zhengbingquant/zhengbingquant_Nano_V1/3. Docs/BOM_Board1_1_PCB2_2025-08-31.xlsx

No. | Quantity | Comment | Designator | Footprint | Value | Manufacturer Part | Manufacturer | Supplier Part | Supplier | LCSC Stock | JLCPCB Price | 淘宝链接 | JLCPCB Stock | LCSC Price
1 | 3 | XL-2012SURC | 3.3V,5V,D13 | LED0805-RD_RED |  | XL-2012SURC | XINGLIGHT(成兴光) | C965812 | LCSC
2 | 6 | 100nF | C2,C3,C9,C12,C14,C17 | C0805 | 100nF | CL21B104KBCWPNC | SAMSUNG(三星) | C346219 | LCSC
3 | 3 | 1uF | C7,C8,C13 | C0805 | 1uF | UMK212BJ105KG-T | TAIYO YUDEN(太诱) | C319195 | LCSC
4 | 1 | 330nF | C11 | C0805 | 330nF | CL21B334KBFNNNE | SAMSUNG(三星) | C73142 | LCSC
5 | 2 | 33pF | C18,C19 | C0805 | 33pF | 0805CG330J500NT | FH(风华) | C157687 | LCSC
6 | 1 | LMSD103AT1G | D1 | SOD-123_L2.8-W1.8-LS3.7-RD |  | LMSD103AT1G | LRC(乐山无线电) | C78727 | LCSC
7 | 1 | BSS138LT1G | Q1 | SOT-23-3_L2.9-W1.6-P1.90-LS2.8-BR |  | BSS138LT1G | onsemi(安森美) | C82045 | LCSC
8 | 2 | 22Ω | R1,R2 | R0603 | 22Ω | 0603WAF220JT5E | UNI-ROYAL(厚声) | C23345 | LCSC
9 | 2 | 5.1kΩ | R3,R4 | R0603 | 5.1kΩ | FRC0603F5101TS | FOJAN(富捷) | C2907044 | LCSC
10 | 1 | 100kΩ | R6 | R0805 | 100kΩ | 0805W8F1003T5E | UNI-ROYAL(厚声) | C149504 | LCSC
11 | 1 | 75Ω | R8 | R0805 | 75Ω | FRC0805J750 TS | FOJAN(富捷) | C2974040 | LCSC
12 | 2 | 160Ω | R9,R20 | R0805 | 160Ω | FRC0805F1600TS | FOJAN(富捷) | C2960793 | LCSC
13 | 4 | 1kΩ | R15,R16,R17,R18 | R0805 | 1kΩ | RC0805FR-071KL | YAGEO(国巨) | C95781 | LCSC
14 | 1 | 10kΩ | R19 | R0805 | 10kΩ | RC0805FR-0710KL | YAGEO(国巨) | C84376 | LCSC
15 | 1 | 3.3MΩ | R21 | R0805 | 3.3MΩ | AC0805FR-073M3L | YAGEO(国巨) | C228805 | LCSC
16 | 2 | XL-2012UYC | RX,TX | LED0805-RD_YELLOW |  | XL-2012UYC | XINGLIGHT(成兴光) | C965814 | LCSC
17 | 1 | TS-1088R-02026 | SW1 | SW-SMD_L3.9-W3.0-P4.45 |  | TS-1088R-02026 | XUNPU(讯普) | C455280 | LCSC
18 | 1 | ATMEGA328P-AU | U1 | TQFP-32_L7.0-W7.0-P0.80-LS9.0-BL |  | ATMEGA328P-AU | MICROCHIP(美国微芯) | C14877 | LCSC
19 | 1 | CH340C | U2 | SOP-16_L10.0-W3.9-P1.27-LS6.0-BL |  | CH340C | WCH(南京沁恒) | C84681 | LCSC
20 | 1 | CJ78L05 | U3 | SOT-89-3_L4.5-W2.5-P1.50-LS4.2-BR |  | CJ78L05 | CJ(江苏长电/长晶) | C2079 | LCSC
21 | 1 | RT9013-33GB | U4 | SOT-23-5_L3.0-W1.7-P0.95-LS2.8-BL |  | RT9013-33GB | RICHTEK(立锜) | C47773 | LCSC
22 | 1 | Nano_pinout | U5 | Nano_pinout
23 | 1 | TYPE-C-31-M-12 | USBC1 | USB-C_SMD-TYPE-C-31-M-12 |  | TYPE-C-31-M-12 | 韩国韩荣 | C165948 | LCSC
24 | 1 | 16MHz | X1 | HC-49US_L11.5-W4.5-P4.88 | 16MHz | 49S-16.000-20-20-20/A | LIMING(利明) | C240920 | LCSC
