zhengbingquant/zhengbingquant_Nano_V1/1. Hardware/zhengbingquant_Nano_V1_schematic.pdf

# DSR# 10 RI# 11 DCD# 12 DTR# 13 RTS# 14 R232 15 VCC 16

# USB TO UART CONVERTER

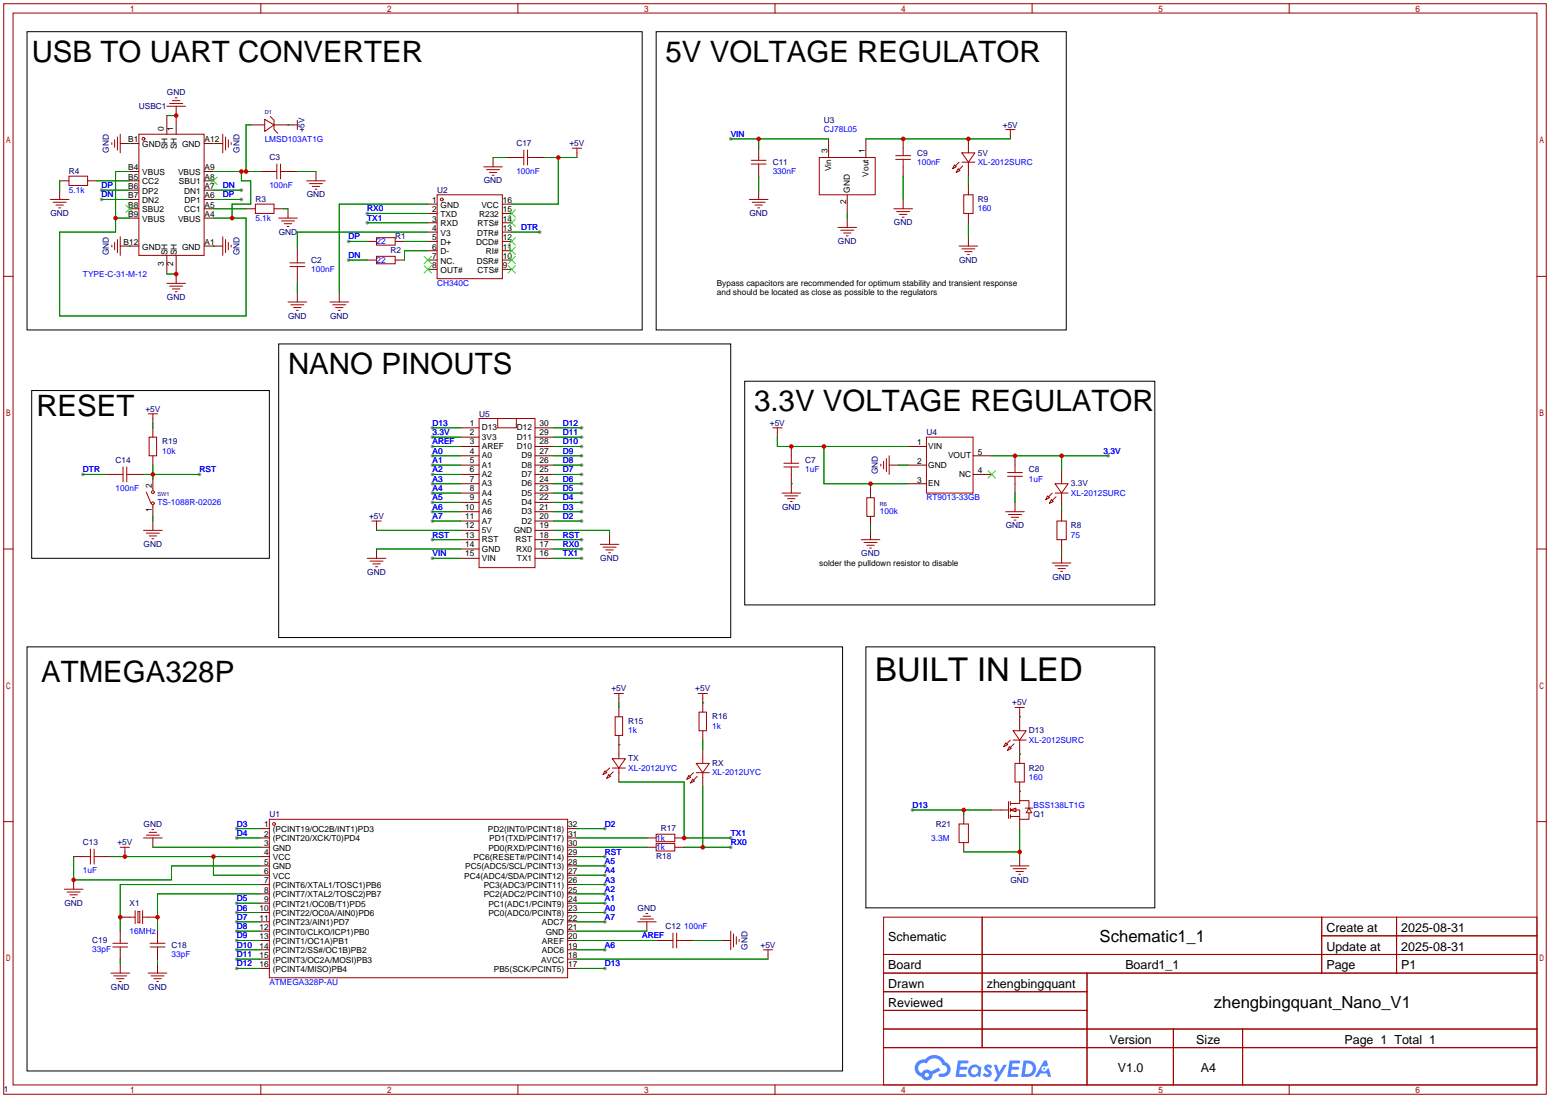
[picture p7: page 1]

Bypass capacitors are recommended for optimum stability and transient response
and should be located as close as possible to the regulators

solder the pulldown resistor to disable

Schematic | Schematic1_1 | Create at | 2025-08-31

Update at | 2025-08-31

Board | Board1_1 | Page | P1
Drawn | zhengbingquant | zhengbingquant_Nano_V1
Reviewed

Version | Size | Page 1 Total 1
V1.0 | A4
