zhengbingquant/zhengbingquant_Nano_V1/(list of files, drawings)

Other design files:
1. Hardware/zhengbingquant_Nano_V1.epro
